dclarkasm/BartendingRobot/Design/pics/iso view.PNG

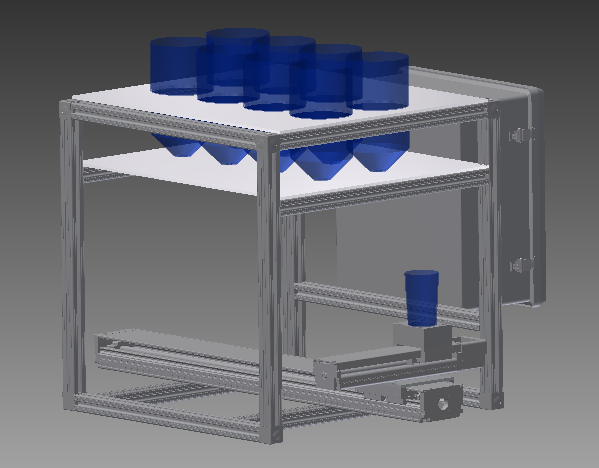
Design/pics/iso view.PNG
