dclarkasm/BartendingRobot/Design/pics/right side.PNG

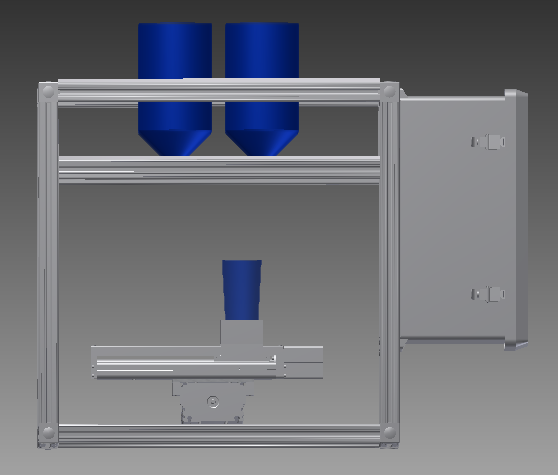
Design/pics/right side.PNG
