dclarkasm/BartendingRobot/programing/mpide/Adafruit-Flow-Meter-master/Adafruit-Flow-Meter-master/README.txt

This is example code for using the Adafruit liquid flow meters. 

Tested and works great with the Adafruit plastic and brass meters
    ------> http://www.adafruit.com/products/828
    ------> http://www.adafruit.com/products/833

Connect the red wire to +5V, the black wire to common ground and the yellow sensor wire to pin #2

Adafruit invests time and resources providing this open source code, 
please support Adafruit and open-source hardware by purchasing 
products from Adafruit!

Written by Limor Fried/Ladyada  for Adafruit Industries.  
BSD license, check license.txt for more information
All text above must be included in any redistribution
