dclarkasm/BartendingRobot/Schematics/flow chart.pptx

System power up

Connect phone to Android IOIO

Open Android application

Normal mode

Wait for drink selection

No drink selected

Manual mode

Set manual control bit to high

Wait for user input
