dclarkasm/BartendingRobot/Schematics/Schematic.pptx

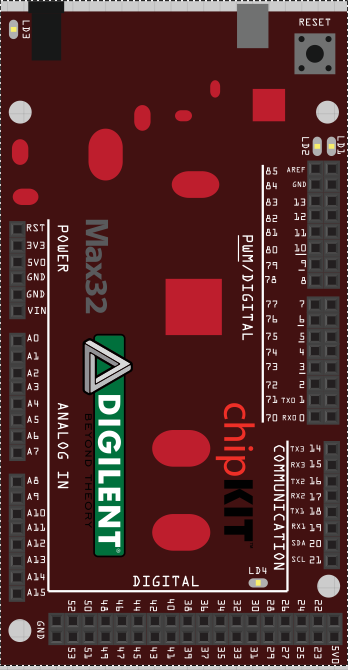
[picture p3: figure]
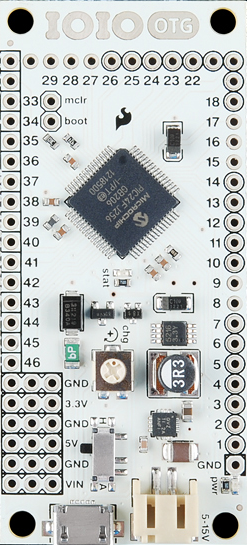
[picture p4: figure]

Key pos 3

Key pos 2

Z Pul

Z Dir

Key pos 1

Key pos 0

Y Pul

Y Dir

X Pul

X Dir

Home sensors

Flow
Meters

Solenoids

## Slide 2

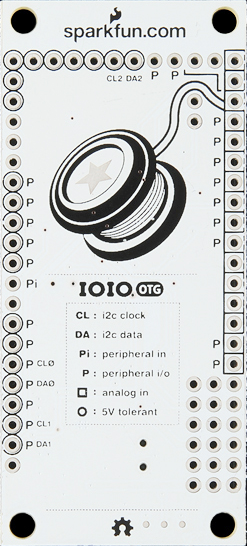
[picture p5: figure]
