dclarkasm/BartendingRobot/Schematics/robot pin out.xlsx

Sheet: Sheet1
descripion | uC | i/o device
screw diver order in | 42 | IOIO 18
cuba libre order in | 43 | IOIO 19 | legend
shiley temple order in | 44 | IOIO 20 | input
matini order in | 45 | IOIO 21 | ouput
manual home | 50 | IOIO 22
jog forward | 43 | IOIO 18
jog right | 44 | IOIO 19
jog reverse | 45 | IOIO 20
jog left | 42 | IOIO 21
manual control | 80 | IOIO 24
y home sensor | 39 | y home sensor
x home sensor | 38 | x home sensor
z home sensor | 41 | z home sensor
flow 1 | 30 | flow 1
flow 2 | 31 | flow 2
flow 3 | 49 | flow 3
flow 4 | 33 | flow 4
flow 5 | 34 | flow 5
flow 6 | 35 | flow 6
flow 7 | 24 | flow 7
flow 8 | 37 | flow 8
jog up | 22 | IOIO 31
jog down | 23 | IOIO 32
manual solenoid bit 1 | 28 | IOIO 33
manual solenoid bit 2 | 25 | IOIO 41
manual solenoid bit 3 | 26 | IOIO 42
manual solenoid bit 4 | 27 | IOIO 43
pulse x | 10 | pulse x
direction x | 11 | direction x
pulse y | 6 | pulse y
direction y | 7 | direction y
pulse z | 8 | pulse z
direction z | 9 | direction z
vodka out | 78 | vodka out
rum out | 71 | rum out
gin out | 72 | gin out
vermouth out | 73 | vermouth out
oj out | 74 | oj out
coke out | 75 | coke out
sprite out | 76 | sprite out
grenadine out | 77 | grenadine out
acknowledgment trans | 48 | IOIO 44

Sheet: Sheet1 (2)
 | description | Pins # | i/o device
 | description | Pins # | i/o device
1 | pulse y | 6 | pulse y
2 | direction y | 7 | direction y | legend
3 | pulse z | 8 | pulse z | input
4 | direction z | 9 | direction z | ouput
5 | pulse x | 10 | pulse x
6 | direction x | 11 | direction x
7 | jog up | 22 | IOIO 31
8 | jog down | 23 | IOIO 32
9 | flow 7 | 24 | flow 7
10 | manual solenoid bit 2 | 25 | IOIO 41
11 | manual solenoid bit 3 | 26 | IOIO 42
12 | manual solenoid bit 4 | 27 | IOIO 43
13 | manual solenoid bit 1 | 28 | IOIO 33
14 | flow 1 | 30 | flow 1
15 | flow 2 | 31 | flow 2
16 | flow 4 | 33 | flow 4
17 | flow 5 | 34 | flow 5
18 | flow 6 | 35 | flow 6
19 | flow 8 | 37 | flow 8
20 | x home sensor | 38 | x home sensor
21 | y home sensor | 39 | y home sensor
22 | z home sensor | 41 | z home sensor
23 | screw diver order in | 42 | IOIO 18
24 | jog left | 42 | IOIO 21
25 | cuba libre order in | 43 | IOIO 19
26 | jog forward | 43 | IOIO 18
27 | shiley temple order in | 44 | IOIO 20
28 | jog right | 44 | IOIO 19
29 | matini order in | 45 | IOIO 21
30 | jog reverse | 45 | IOIO 20
31 | acknowledgment trans | 48 | IOIO 44
32 | flow 3 | 49 | flow 3
33 | manual home | 50 | IOIO 22
34 | rum out | 71 | rum out
35 | gin out | 72 | gin out
36 | vermouth out | 73 | vermouth out
37 | oj out | 74 | oj out
38 | coke out | 75 | coke out
39 | sprite out | 76 | sprite out
40 | grenadine out | 77 | grenadine out
41 | vodka out | 78 | vodka out
42 | manual control | 80 | IOIO 24
