dclarkasm/BartendingRobot/Design/Panel asm2 drawing.pdf

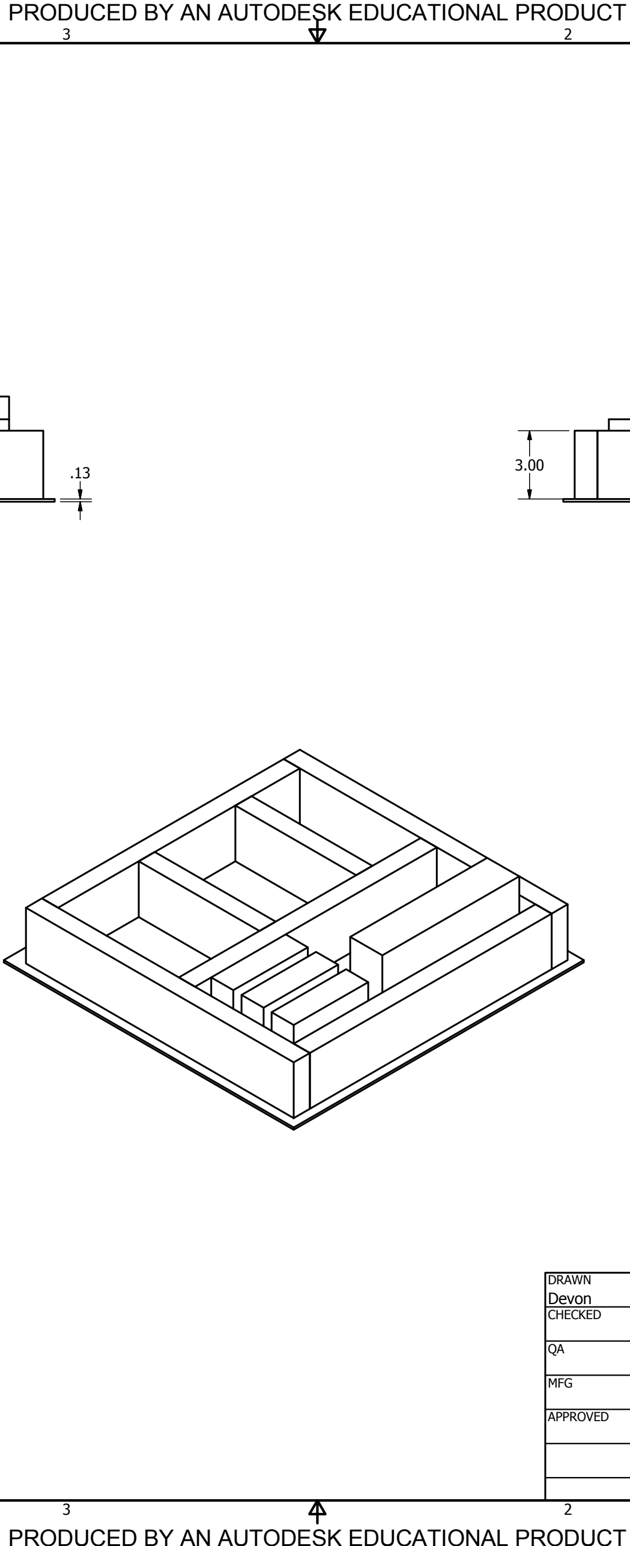
[picture p6: figure]
TIO N

PRODUCED BY AN AUTODESK EDUCATIONAL PRODUCT PRODUCED BY AN AUTODESK EDUCATIONAL PRODUCT

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
el a

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
