dclarkasm/BartendingRobot/Android App/pics/Account.PNG

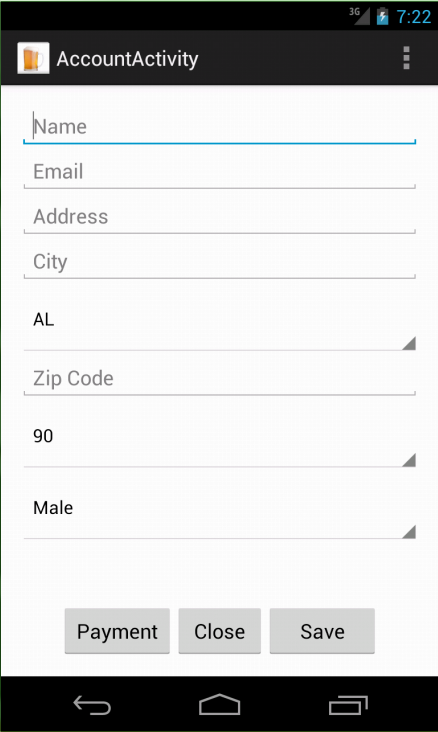
Android App/pics/Account.PNG
