dclarkasm/BartendingRobot/Android App/pics/App design.PNG

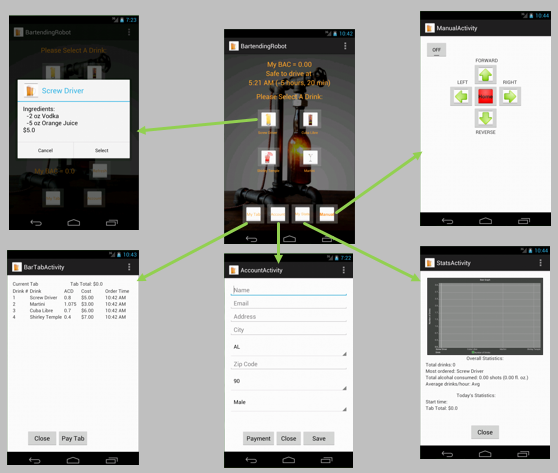
Android App/pics/App design.PNG
