dclarkasm/BartendingRobot/Android App/pics/bar tab.PNG

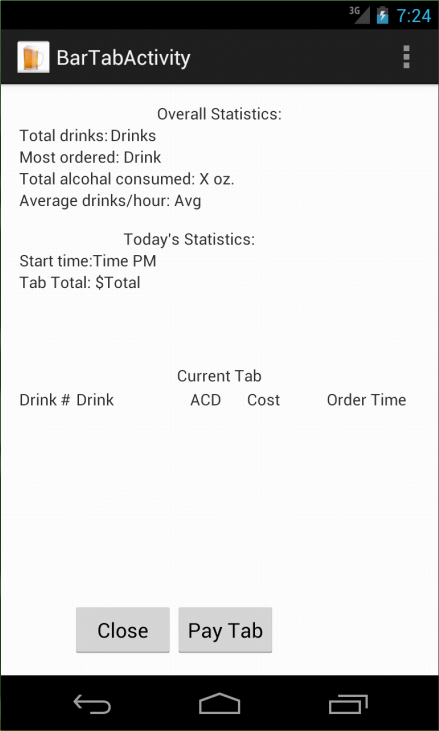
Android App/pics/bar tab.PNG
