dclarkasm/BartendingRobot/Android App/pics/downarrow.png

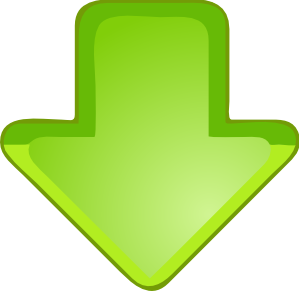
Android App/pics/downarrow.png
