dclarkasm/BartendingRobot/Android App/pics/drink select.PNG

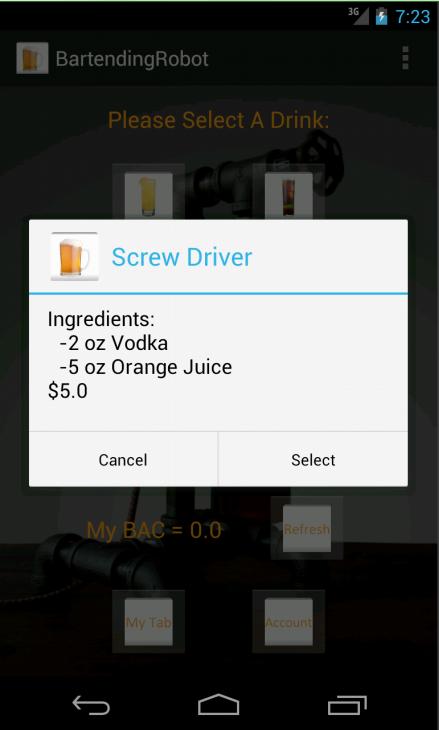
Android App/pics/drink select.PNG
