dclarkasm/BartendingRobot/Android App/pics/home screen.PNG

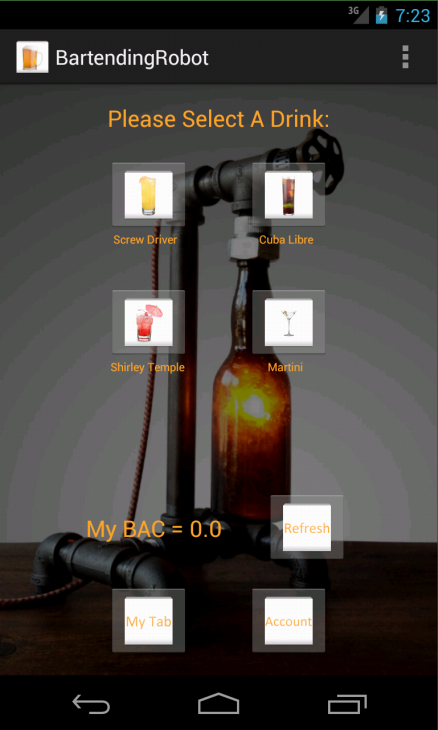
Android App/pics/home screen.PNG
