dclarkasm/BartendingRobot/Android App/pics/leftarrow.png

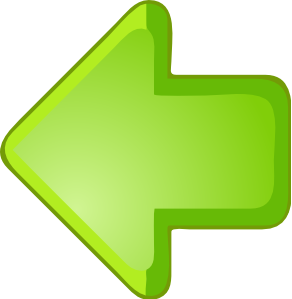
Android App/pics/leftarrow.png
