dclarkasm/BartendingRobot/Android App/pics/rightarrow.png

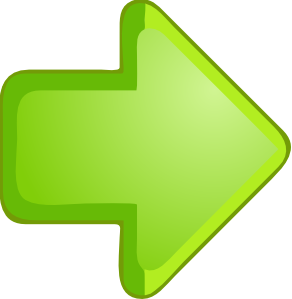
Android App/pics/rightarrow.png
