dclarkasm/BartendingRobot/Design/front.PNG

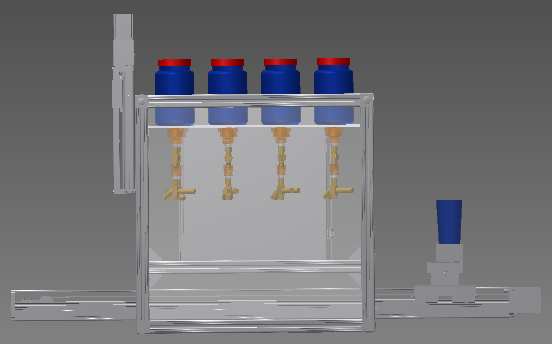
Design/front.PNG
