dclarkasm/BartendingRobot/Design/panel drawing.PNG

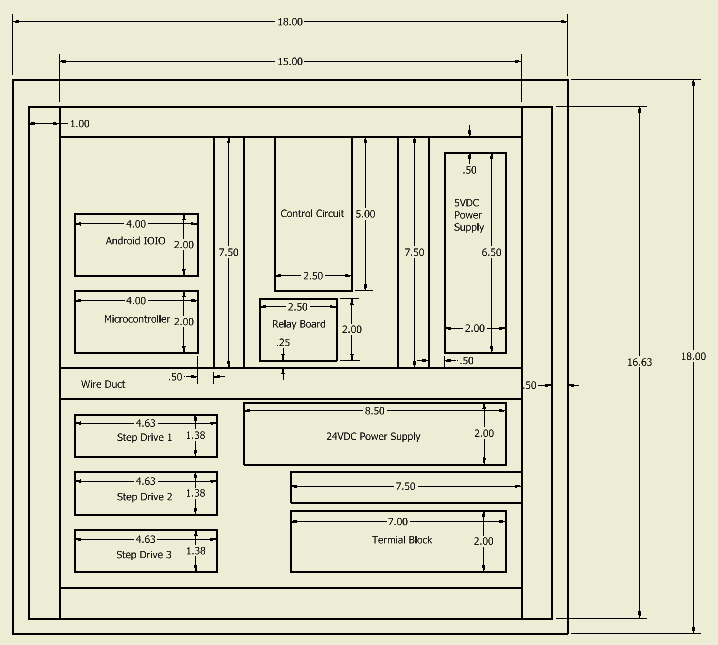
Design/panel drawing.PNG
