dclarkasm/BartendingRobot/Design/panel model.PNG

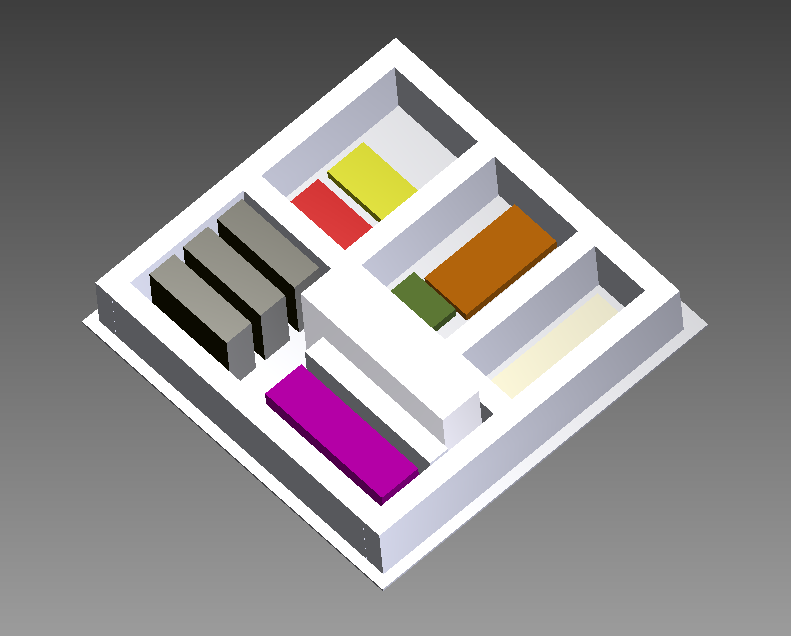
Design/panel model.PNG
