dclarkasm/BartendingRobot/Design/pics/front.PNG

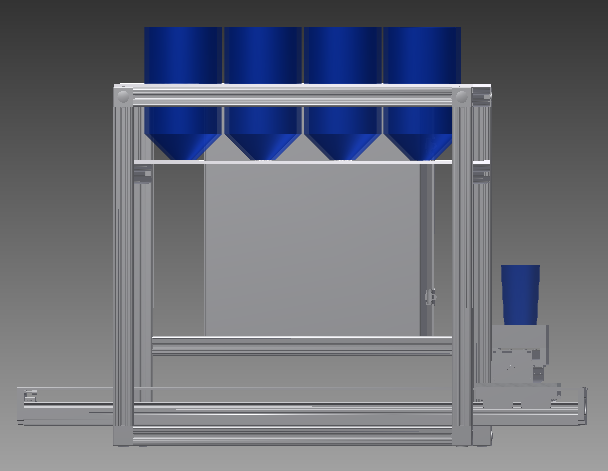
Design/pics/front.PNG
