dclarkasm/BartendingRobot/Design/side.PNG

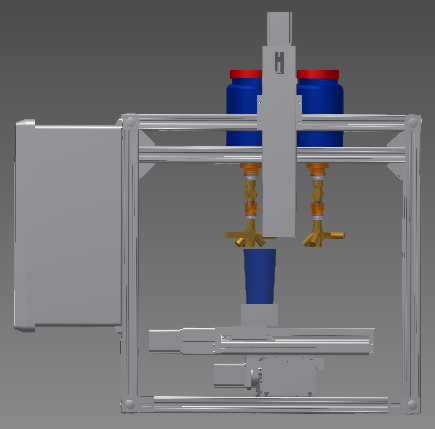
Design/side.PNG
