dclarkasm/BartendingRobot/Design/top.PNG

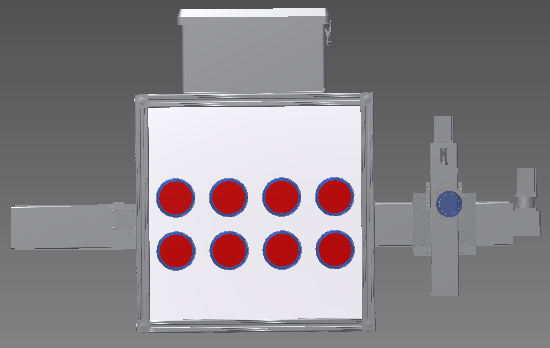
Design/top.PNG
