dclarkasm/BartendingRobot/Schematics/20140426_170252.jpg

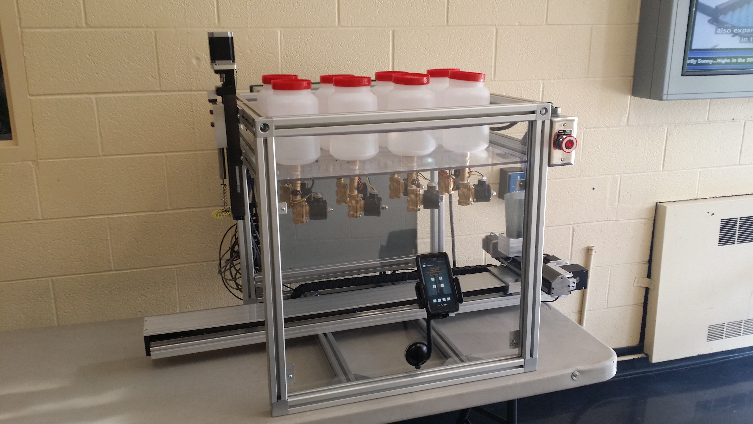
Schematics/20140426_170252.jpg
