dclarkasm/BartendingRobot/Schematics/20140426_170310.jpg

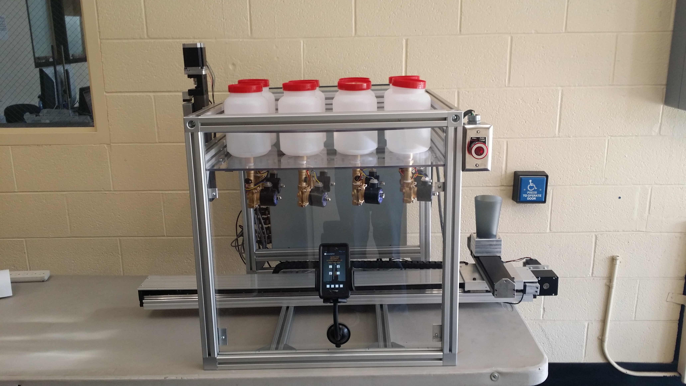
Schematics/20140426_170310.jpg
