dclarkasm/BartendingRobot/Schematics/20140426_170319.jpg

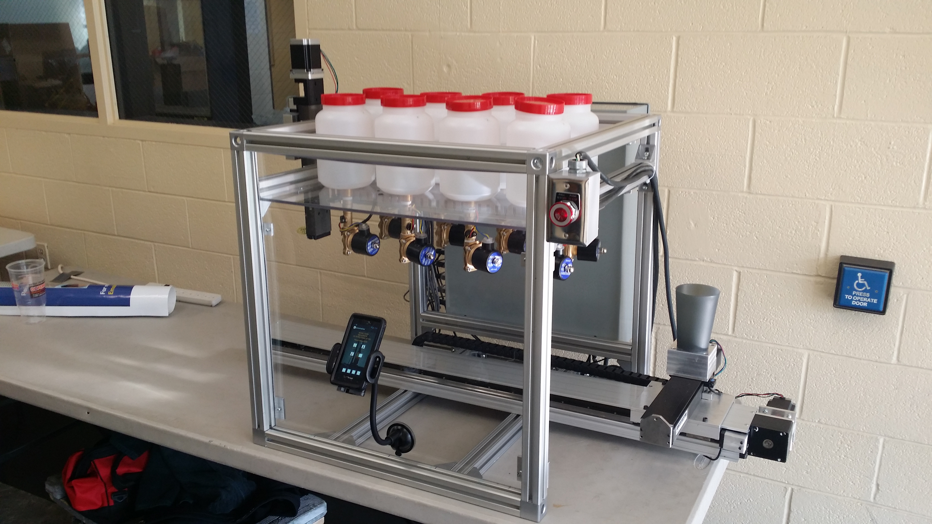
Schematics/20140426_170319.jpg
