dclarkasm/BartendingRobot/Schematics/app flow.PNG

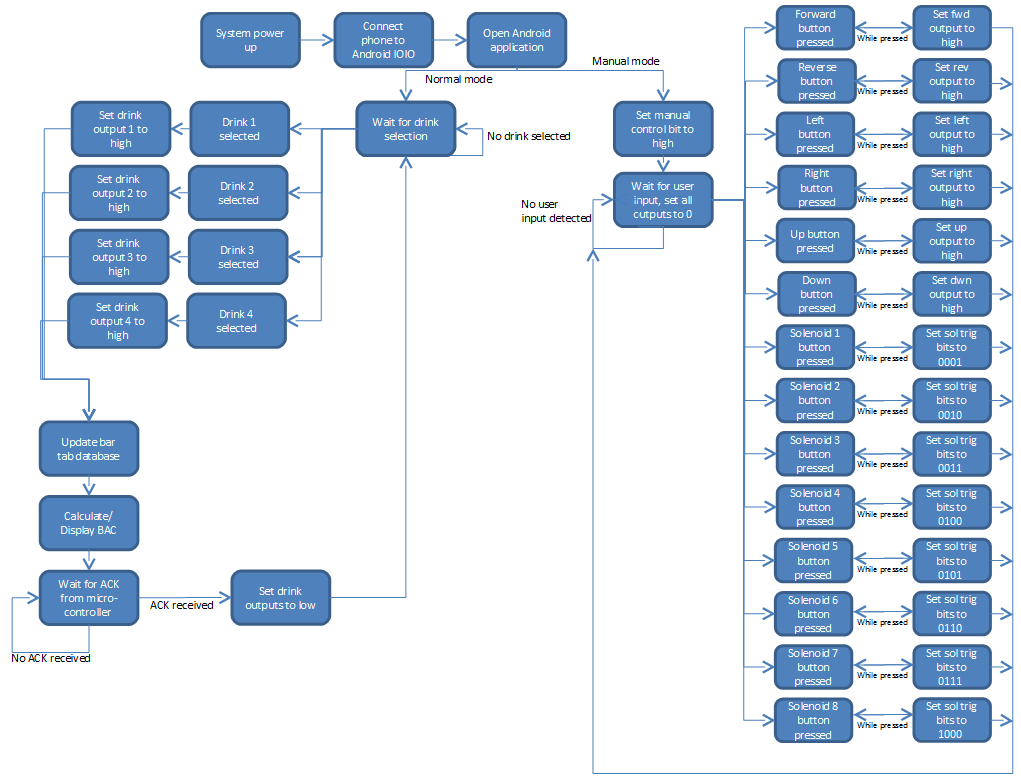
Schematics/app flow.PNG
