dclarkasm/BartendingRobot/Schematics/Block Diagram.bmp

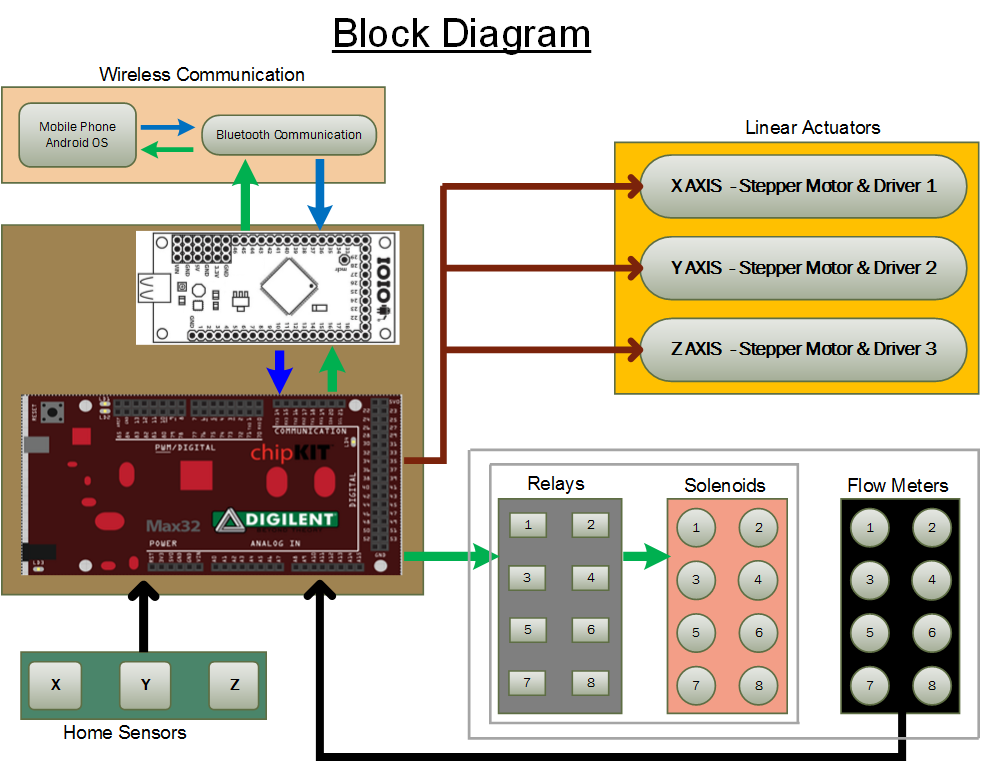
Schematics/Block Diagram.bmp
