dclarkasm/BartendingRobot/Schematics/drink flow.PNG

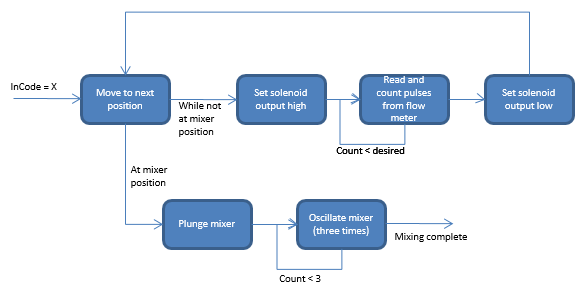
Schematics/drink flow.PNG
