dclarkasm/BartendingRobot/Schematics/micro c flow.PNG

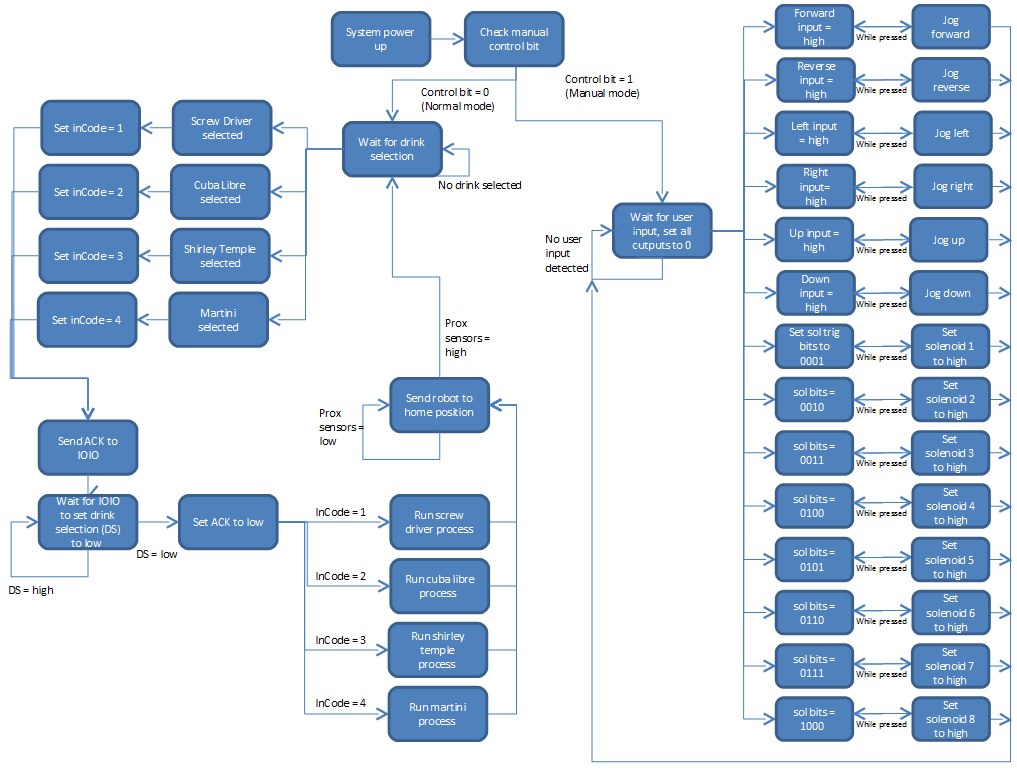
Schematics/micro c flow.PNG
