dclarkasm/BartendingRobot/Schematics/regulators.PNG

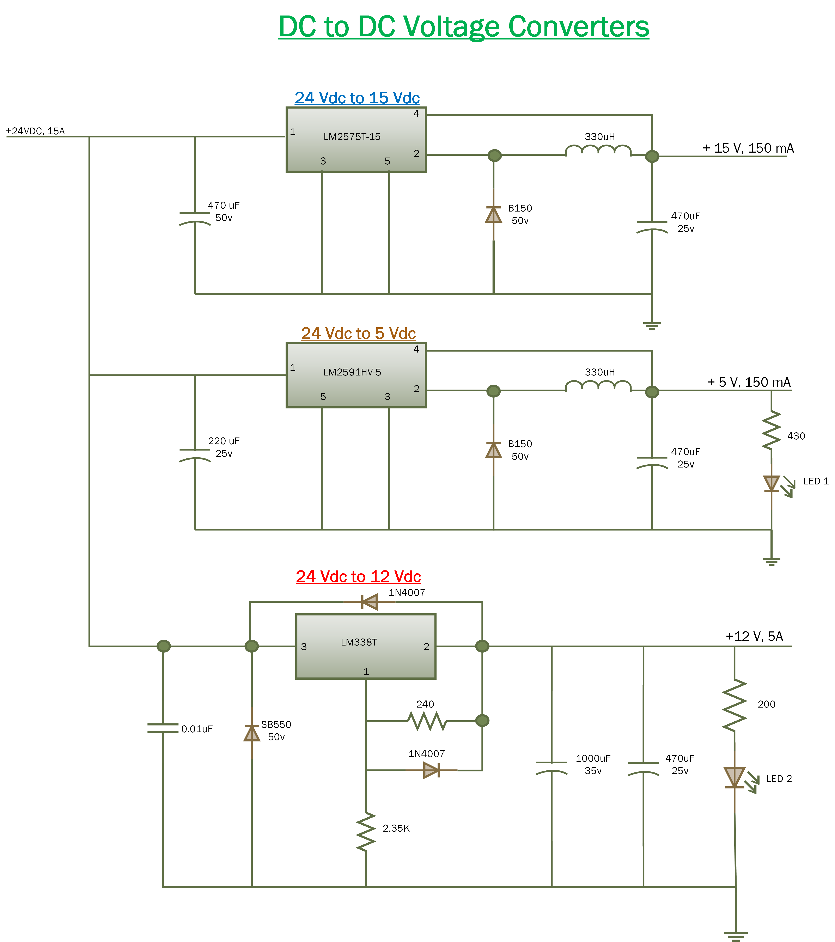
Schematics/regulators.PNG
