dclarkasm/BartendingRobot/Schematics/Solenoids.PNG

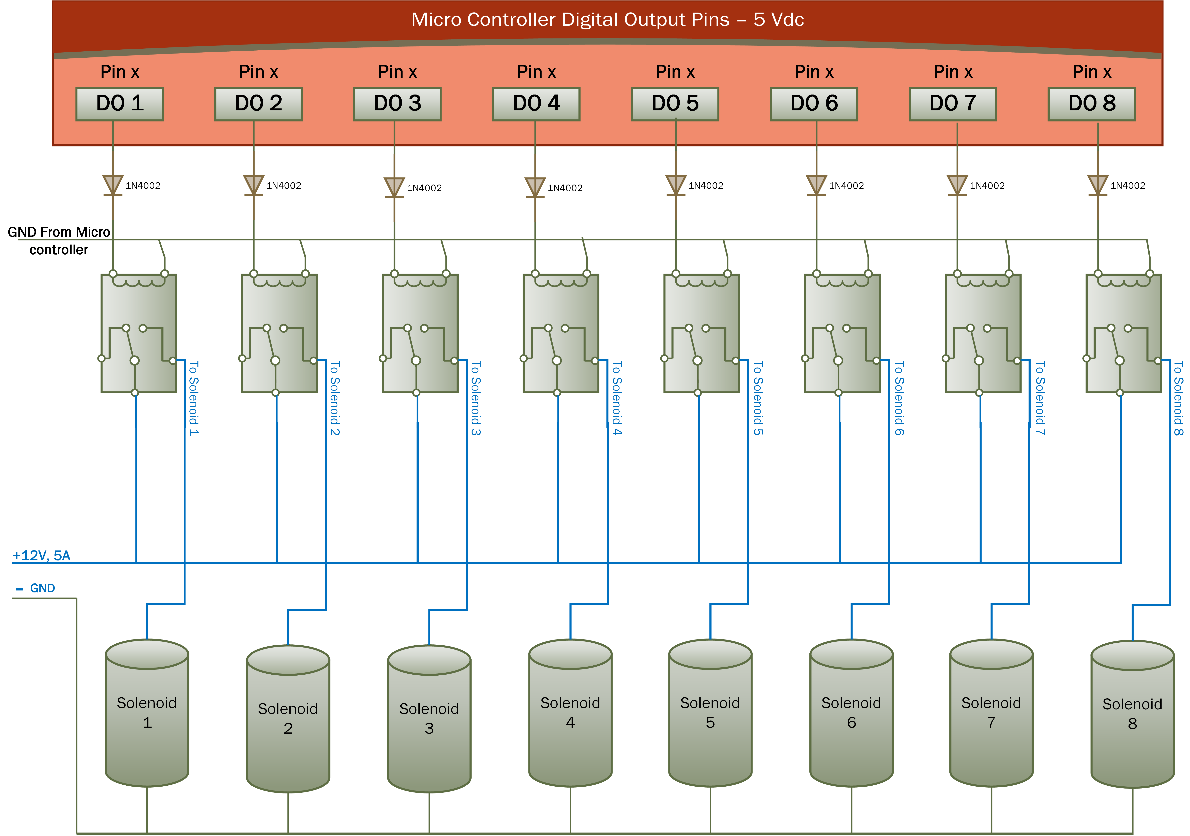
Schematics/Solenoids.PNG
