dclarkasm/BartendingRobot/Schematics/unnamed.jpg

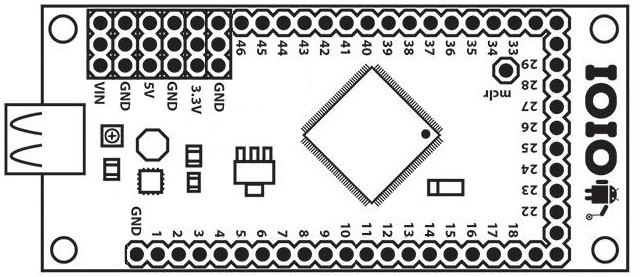
Schematics/unnamed.jpg
