dclarkasm/BartendingRobot/Design/flow/.5-.375in coupling.IGS

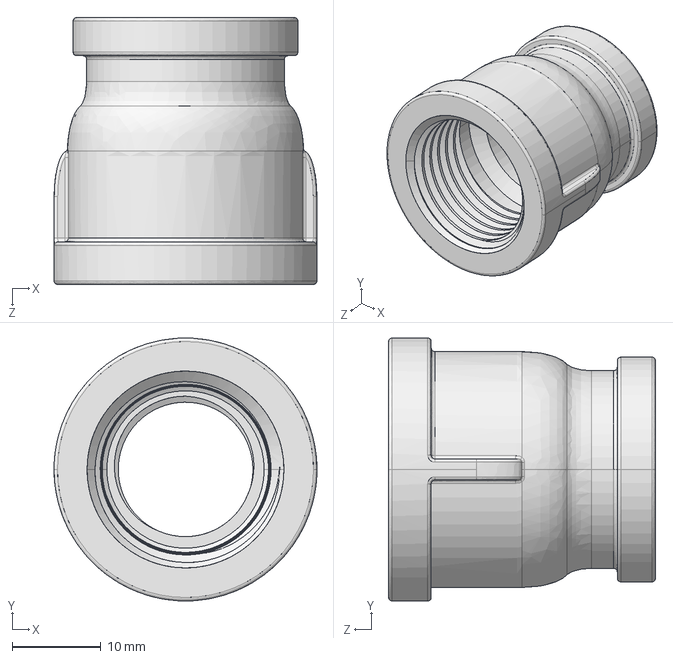
[picture p31: CAD file, 2016-03-17]
Design/flow/.5-.375in coupling.IGS
29.7 x 29.7 x 30.2 mm
