dclarkasm/BartendingRobot/Design/flow/.375 nipple.IGS

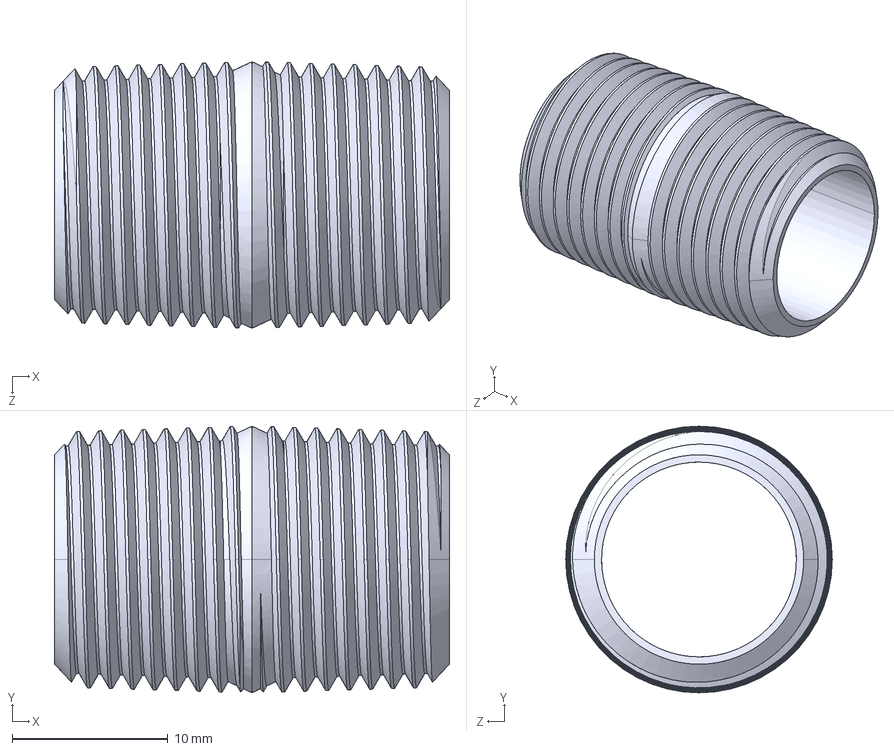
[picture p32: CAD file, 2016-03-17]
Design/flow/.375 nipple.IGS
25.4 x 17.1 x 17.1 mm
