dclarkasm/BartendingRobot/Design/flow/.5 in bulkhead fitting.IGS

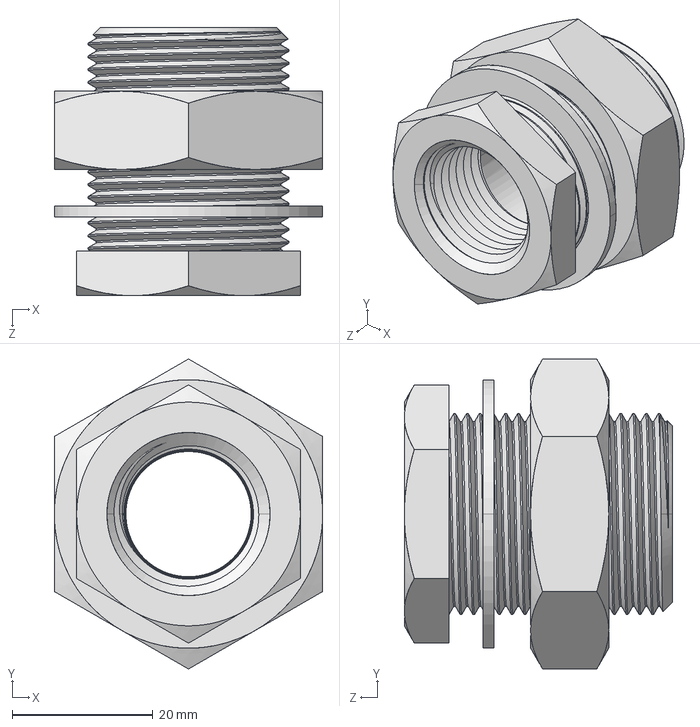
[picture p33: CAD file, 2016-03-17]
Design/flow/.5 in bulkhead fitting.IGS
38.1 x 44.0 x 38.1 mm
