dclarkasm/BartendingRobot/Design/flow/.5in nipple.IGS

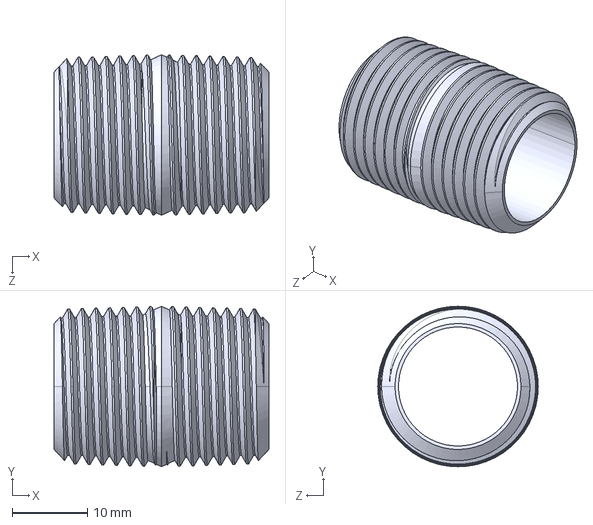
[picture p34: CAD file, 2016-03-17]
Design/flow/.5in nipple.IGS
28.6 x 21.3 x 21.3 mm
