dclarkasm/BartendingRobot/Design/Electrical/7641K711.STEP

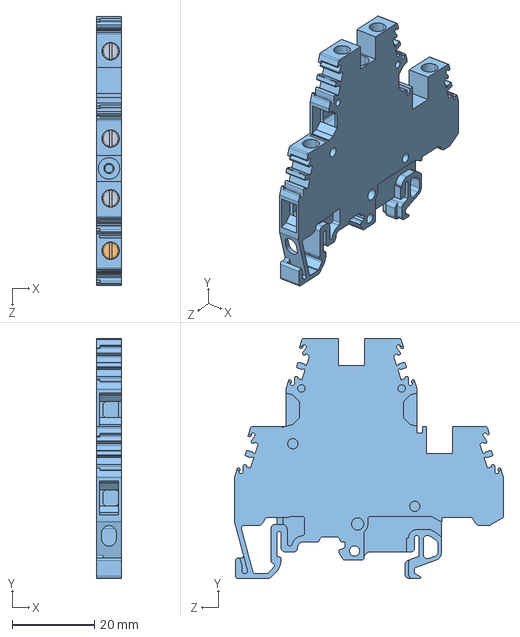
[picture p35: CAD file, 2016-03-17]
Design/Electrical/7641K711.STEP
6.00 x 58.5 x 65.6 mm
