dclarkasm/BartendingRobot/Design/extrusion fittings/5537T510.STEP

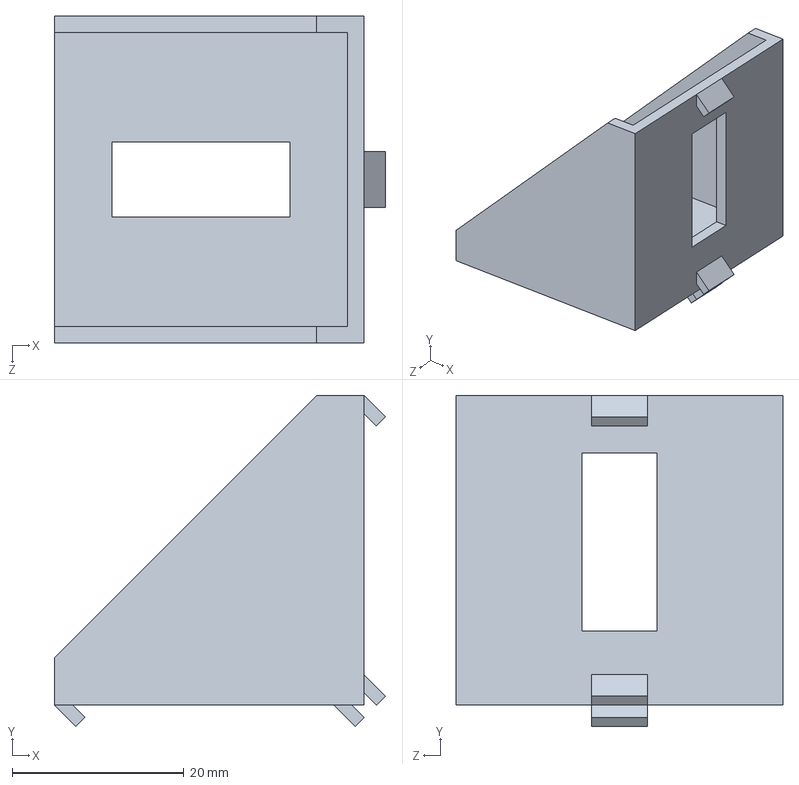
[picture p36: CAD file, 2016-03-17]
Design/extrusion fittings/5537T510.STEP
38.5 x 38.5 x 38.0 mm
