dclarkasm/BartendingRobot/Design/flow/36895K161.IGS

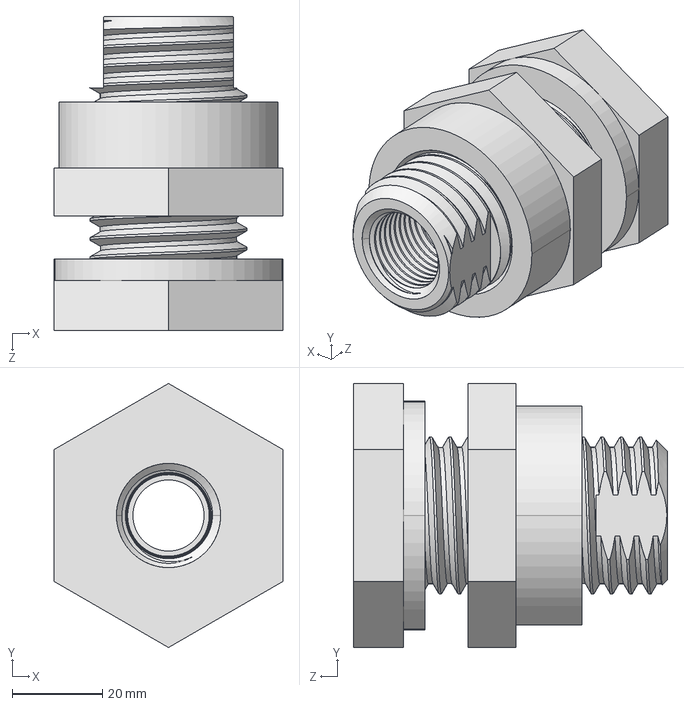
[picture p37: CAD file, 2016-03-17]
Design/flow/36895K161.IGS
50.8 x 58.7 x 69.8 mm
