dclarkasm/BartendingRobot/(list of files, cad)

Other CAD files:
Design/servo motor/QCI-A23L-1_SW/23 Extrusion with connector and seal.sldasm
Design/servo motor/QCI-A23L-1_SW/QCI-A23L-1.sldasm
Design/servo motor/QCI-A23L-1_SW/Web page info.sldprt
Design/servo motor/QCI-A23L-1_SW/extrusion.sldprt
Design/servo motor/QCI-A23L-1_SW/QCI.sldprt
Design/servo motor/QCI-A23L-1_SW/15 pin HD M.sldprt
Design/servo motor/QCI-A23L-1_SW/23 Label.sldprt
Design/servo motor/QCI-A23L-1_SW/23L-1.sldprt
Design/servo motor/QCI-A23L-1_SW/4-40 jack screw.sldprt
Design/1.5 in. aluminum extrusion/14.156in.ipt
Design/1.5 in. aluminum extrusion/5.094in.ipt
Design/1.5 in. aluminum extrusion/7in.ipt
Design/1.5 in. aluminum extrusion/Imported Components/47065T210/OldVersions/Part32.0001.ipt
Design/1.5 in. aluminum extrusion/Imported Components/47065T210/OldVersions/Part34.0001.ipt
Design/1.5 in. aluminum extrusion/Imported Components/47065T210/Part10.ipt
Design/1.5 in. aluminum extrusion/Imported Components/47065T210/Part2.ipt
Design/1.5 in. aluminum extrusion/Imported Components/47065T210/Part3.ipt
Design/1.5 in. aluminum extrusion/Imported Components/47065T210/Part32.ipt
Design/1.5 in. aluminum extrusion/Imported Components/47065T210/Part34.ipt
Design/1.5 in. aluminum extrusion/Imported Components/47065T210/Part4.ipt
Design/1.5 in. aluminum extrusion/Imported Components/47065T210/Part5.ipt
Design/1.5 in. aluminum extrusion/OldVersions/7in.0001.ipt
Design/340mm KR linear actuator/PARTserver64609951/KR45H 10A + 340L0 - 00A0(0-0).iam
Design/340mm KR linear actuator/PARTserver64609951/KR45H(A-1)-Slider.ipt
Design/340mm KR linear actuator/PARTserver64609951/KR45HA-340L-0A0-Body.ipt
Design/340mm KR linear actuator/PARTserver64610126with cover/KR45H 10A + 340L0 - 10A0(0-0).iam
Design/340mm KR linear actuator/PARTserver64610126with cover/KR45H(A-1)-Slider.ipt
Design/340mm KR linear actuator/PARTserver64610126with cover/KR45H-340-Protected Cover.ipt
Design/340mm KR linear actuator/PARTserver64610126with cover/KR45H-A-Slider Spacer.ipt
Design/340mm KR linear actuator/PARTserver64610126with cover/KR45HA-340L-1A0-Body.ipt
Design/980mm KR linear actuator/KR55 20A + 980L0 - 10A0(826-0).iam
Design/980mm KR linear actuator/KR55(A-1)-Slider.ipt
Design/980mm KR linear actuator/KR55-980-Protected Cover.ipt
Design/980mm KR linear actuator/KR55-A-Slider Spacer.ipt
Design/980mm KR linear actuator/KR55A-980L-1A0-Body.ipt
Design/980mm KR linear actuator/NEMA23 frame size/GL20N-142-SW-EH--C-N-N-Y_(804U1).iam
Design/980mm KR linear actuator/NEMA23 frame size/GL20N41420CSW' Body2.ipt
Design/980mm KR linear actuator/NEMA23 frame size/GL20NL-typeExNY Table.ipt
Design/980mm KR linear actuator/NEMA23 frame size/GL20NU1 Y Motor bracket.ipt
Design/Bartender Robot Asm-1 drawing.idw
Design/Bartender Robot Asm.iam
Design/Electrical/15in wire duct.ipt
Design/Electrical/17in wire duct.ipt
Design/Electrical/2x6.5 PCB.ipt
Design/Electrical/4x6.5 PCB.ipt
Design/Electrical/5.625in wire duct.ipt
Design/Electrical/7.5in wire duct.ipt
Design/Electrical/AND Gate.ipt
Design/Electrical/IOIO.ipt
Design/Electrical/Imported Components/7641K711/7641K711.ipt
Design/Electrical/OldVersions/17in wire duct.0001.ipt
Design/Electrical/OldVersions/4x6.5 PCB.0001.ipt
Design/Electrical/OldVersions/Panel asm.0002.iam
Design/Electrical/OldVersions/Panel asm.0004.iam
Design/Electrical/OldVersions/Power Suplply.0001.ipt
Design/Electrical/OldVersions/Power Suplply.0002.ipt
Design/Electrical/OldVersions/Stepper Drive.0001.ipt
Design/Electrical/Panel asm.iam
Design/Electrical/Power Suplply.ipt
Design/Electrical/Stepper Drive.ipt
Design/Electrical/chipkit.ipt
Design/Electrical/panel.ipt
Design/Electrical/relay board.ipt
Design/Electrical/terminal block.ipt
Design/Enclosure/Imported Components/Enclosure/Assembly3.iam
Design/Enclosure/Imported Components/Enclosure/OldVersions/Assembly3.0001.iam
Design/Enclosure/Imported Components/Enclosure/OldVersions/Part18.0001.ipt
Design/Enclosure/Imported Components/Enclosure/OldVersions/Part20.0001.ipt
Design/Enclosure/Imported Components/Enclosure/OldVersions/Part22.0001.ipt
Design/Enclosure/Imported Components/Enclosure/OldVersions/Part24.0001.ipt
Design/Enclosure/Imported Components/Enclosure/OldVersions/Part26.0001.ipt
Design/Enclosure/Imported Components/Enclosure/OldVersions/Part28.0001.ipt
Design/Enclosure/Imported Components/Enclosure/OldVersions/Part30.0001.ipt
Design/Enclosure/Imported Components/Enclosure/Part18.ipt
Design/Enclosure/Imported Components/Enclosure/Part20.ipt
Design/Enclosure/Imported Components/Enclosure/Part22.ipt
Design/Enclosure/Imported Components/Enclosure/Part24.ipt
Design/Enclosure/Imported Components/Enclosure/Part26.ipt
Design/Enclosure/Imported Components/Enclosure/Part28.ipt
Design/Enclosure/Imported Components/Enclosure/Part30.ipt
Design/GL-N linear actuator/PARTserver64595412/GL15N-124-SW-EH--N-N-N-Y_(02N).iam
Design/GL-N linear actuator/PARTserver64595412/GL15N21240NSW' Body2.ipt
Design/GL-N linear actuator/PARTserver64595412/GL15NL-typeExSWNY Table.ipt
Design/GL-N linear actuator/PARTserver64610223withcover/GL15N-106-SW-B05-A-C-N-N-Y_(01A).iam
Design/GL-N linear actuator/PARTserver64610223withcover/GL15N11060CASW' Body2.ipt
Design/GL-N linear actuator/PARTserver64610223withcover/GL15NL-typeBxSWNY Table.ipt
Design/Imported Components/5537T510/OldVersions/Part6.0001.ipt
Design/Imported Components/5537T510/Part10.ipt
Design/Imported Components/5537T510/Part12.ipt
Design/Imported Components/5537T510/Part4.ipt
Design/Imported Components/5537T510/Part6.ipt
Design/Imported Components/5537T510/Part8.ipt
Design/Liquid Vessel/OldVersions/Vessel.0005.ipt
Design/Liquid Vessel/Vessel.ipt
Design/Liquid Vessel/cap.ipt
Design/OldVersions/Bartender Robot Asm-1 drawing.0001.idw
Design/OldVersions/Bartender Robot Asm-1 drawing.0002.idw
Design/OldVersions/Bartender Robot Asm-1 drawing.0003.idw
Design/OldVersions/Bartender Robot Asm.0011.iam
Design/OldVersions/Bartender Robot Asm.0012.iam
Design/OldVersions/Panel asm1 drawing.0001.idw
Design/OldVersions/Panel asm1 drawing.0003.idw
Design/Panel asm1 drawing.idw
Design/Panel asm2 drawing.idw
Design/VLA linear actuator/VLA-60-06-0700-N-000-N-N-N (0) (700).iam
Design/VLA linear actuator/VLA-ST-60-12-0050WSlider.ipt
Design/VLA linear actuator/VLA-ST-60-12-0700W Body.ipt
Design/extrusion fittings/Imported Components/1.5in 2 sided fastener/Assembly1.iam
Design/extrusion fittings/Imported Components/1.5in 2 sided fastener/Assembly2.iam
Design/extrusion fittings/Imported Components/1.5in 2 sided fastener/OldVersions/Assembly2.0001.iam
Design/extrusion fittings/Imported Components/1.5in 2 sided fastener/Part12.ipt
Design/extrusion fittings/Imported Components/1.5in 2 sided fastener/Part14.ipt
Design/extrusion fittings/Imported Components/1.5in 2 sided fastener/Part16.ipt
Design/extrusion fittings/Imported Components/1.5in 2 sided fastener/Part24.ipt
Design/extrusion fittings/Imported Components/1.5in 2 sided fastener/Part26.ipt
Design/extrusion fittings/Imported Components/1.5in 2 sided fastener/Part28.ipt
Design/extrusion fittings/Imported Components/1.5in 2 sided fastener/Part4.ipt
Design/extrusion fittings/Imported Components/1.5in 2 sided fastener/Part6.ipt
Design/extrusion fittings/Imported Components/1.5in 2 sided fastener/Part8.ipt
Design/extrusion fittings/Imported Components/1.5in 3 sided fastener/Assembly1.iam
Design/extrusion fittings/Imported Components/1.5in 3 sided fastener/Assembly2.iam
Design/extrusion fittings/Imported Components/1.5in 3 sided fastener/Assembly5.iam
Design/extrusion fittings/Imported Components/1.5in 3 sided fastener/Part10.ipt
Design/extrusion fittings/Imported Components/1.5in 3 sided fastener/Part12.ipt
Design/extrusion fittings/Imported Components/1.5in 3 sided fastener/Part14.ipt
Design/extrusion fittings/Imported Components/1.5in 3 sided fastener/Part16.ipt
Design/extrusion fittings/Imported Components/1.5in 3 sided fastener/Part2.ipt
Design/extrusion fittings/Imported Components/1.5in 3 sided fastener/Part36.ipt
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
