dclarkasm/BartendingRobot/Design/Final Mechanical Assembly.PNG

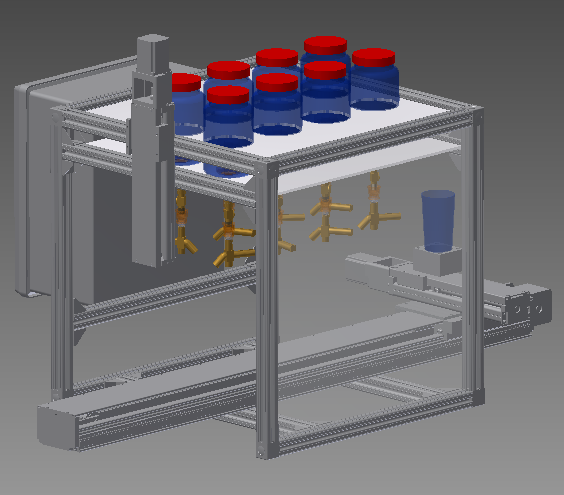
Design/Final Mechanical Assembly.PNG
