dclarkasm/BartendingRobot/Design/Bartender Robot Asm-1 drawing.pdf

## PRODUCED BY AN AUTODESK EDUCATIONAL PRODUCT

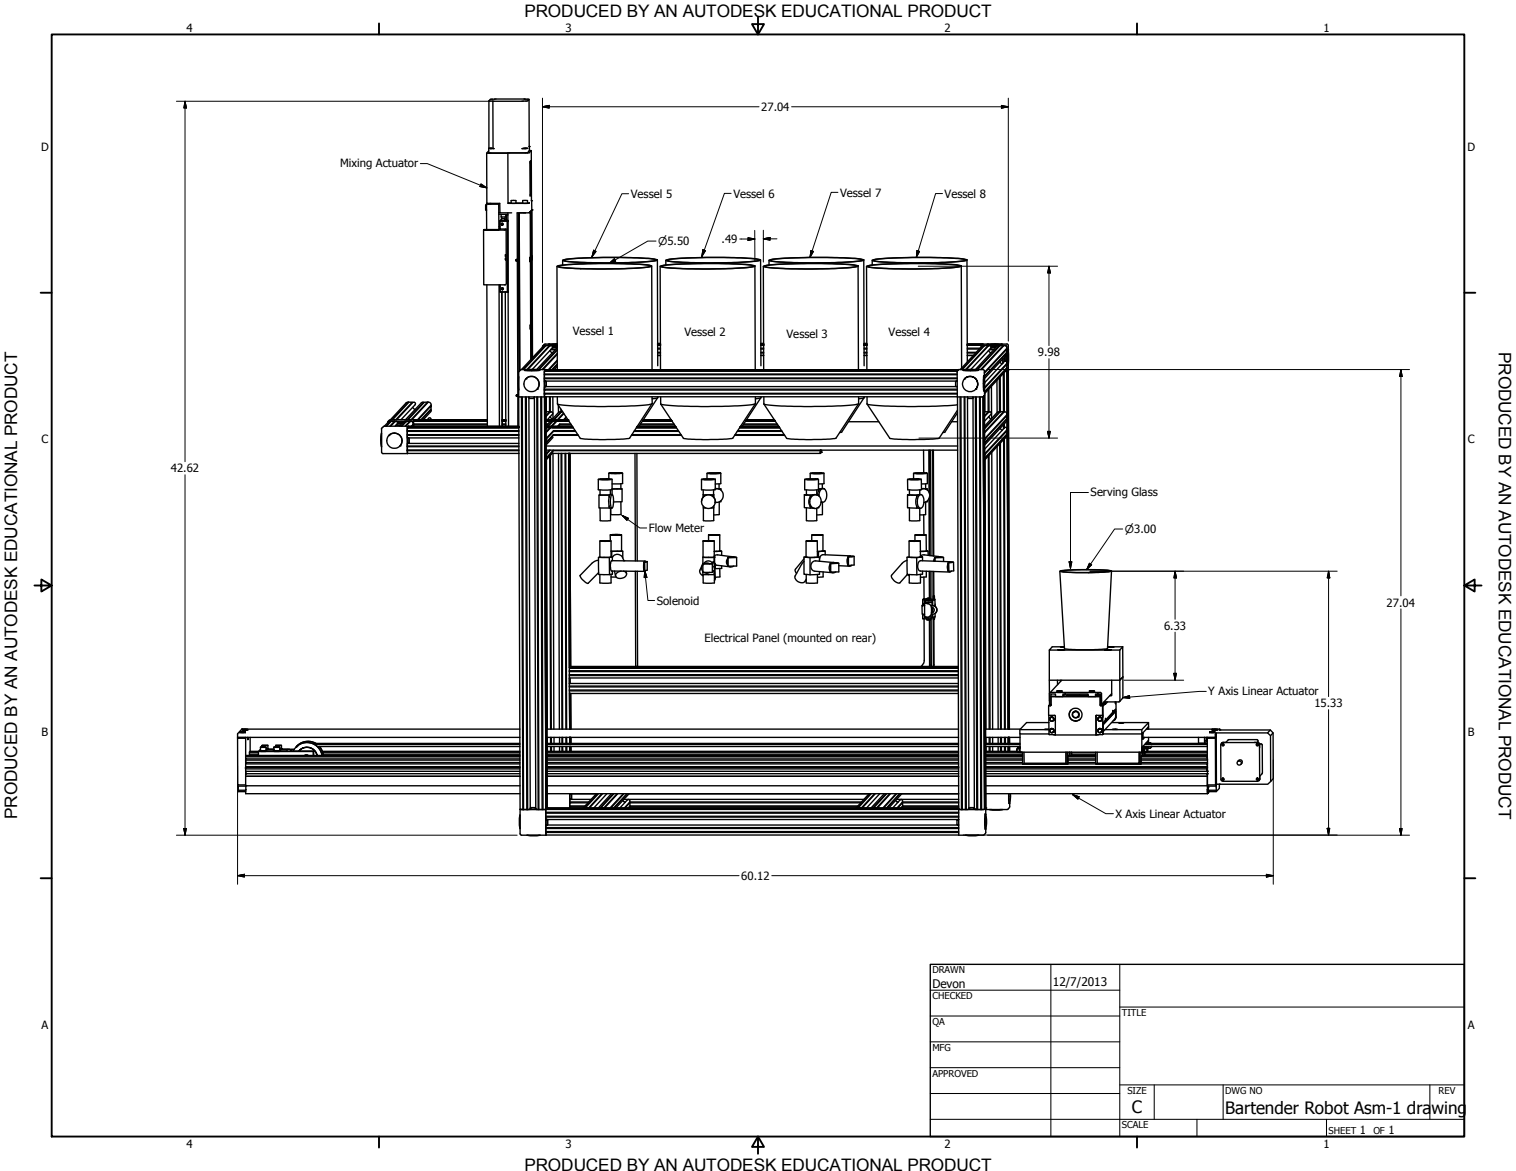
[picture p39: page 1]
TIO; P R O D U C E D B Y A N A U T O D E S K E D U C A TIO; SHEET 1 OF 1; DRAWN; CHECKED; MFG; APPROVED; Devon; TITLE; SIZE C; SCALE; REV; Vessel 1; Vessel 2; Vessel 3; Vessel 4; Solenoid; Flow Meter; Mixing Actuator; Serving Glass; Vessel 5; Vessel 6; Vessel 7; Vessel 8

Electrical Panel (mounted on rear)

Y Axis Linear Actuator

X Axis Linear Actuator

DWG NO
Bartender Robot Asm-1 drawing

PRODUCED BY AN AUTODESK EDUCATIONAL PRODUCT
