dclarkasm/BartendingRobot/Schematics/SchematicsAllinOne.pdf

# Block Diagram

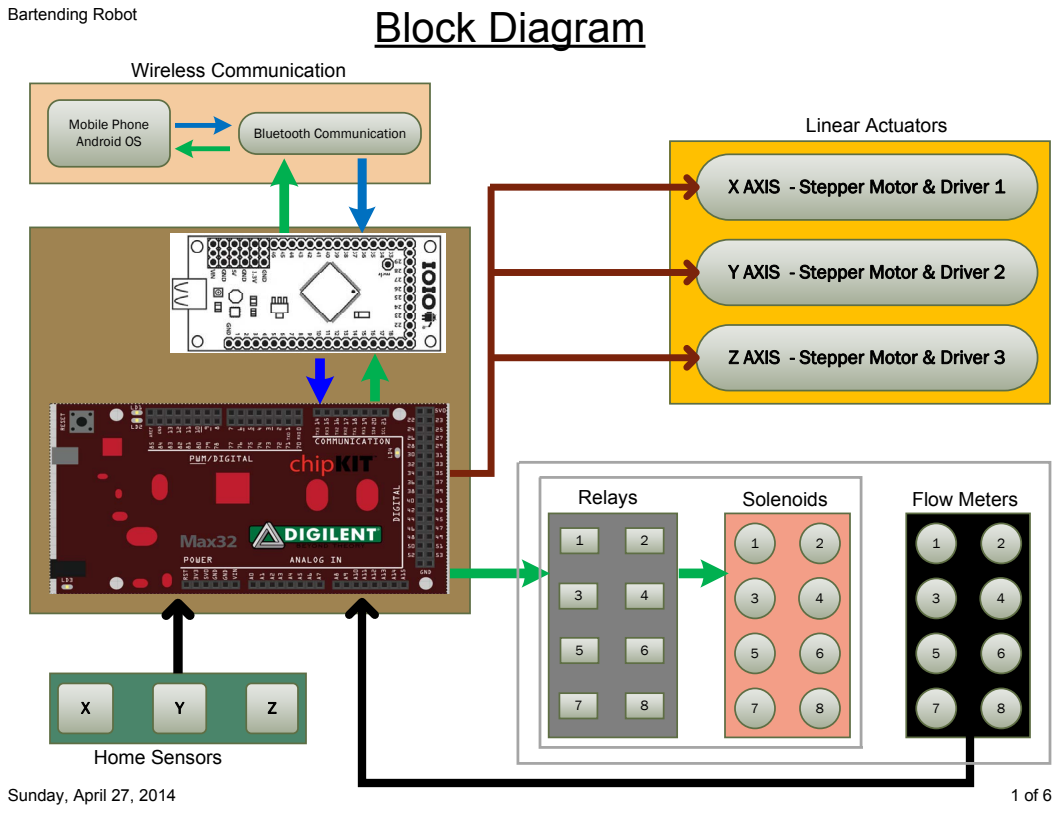
[picture p40: page 1]
Wireless Communication; Mobile Phone; Android OS; Bluetooth Communication; Linear Actuators; Bartending Robot; Sunday, April 27, 2014; Relays; Solenoids; Flow Meters; Home Sensors

X AXIS - Stepper Motor & Driver 1

Y AXIS - Stepper Motor & Driver 2

Z AXIS - Stepper Motor & Driver 3

## Microcontroller and IOIO

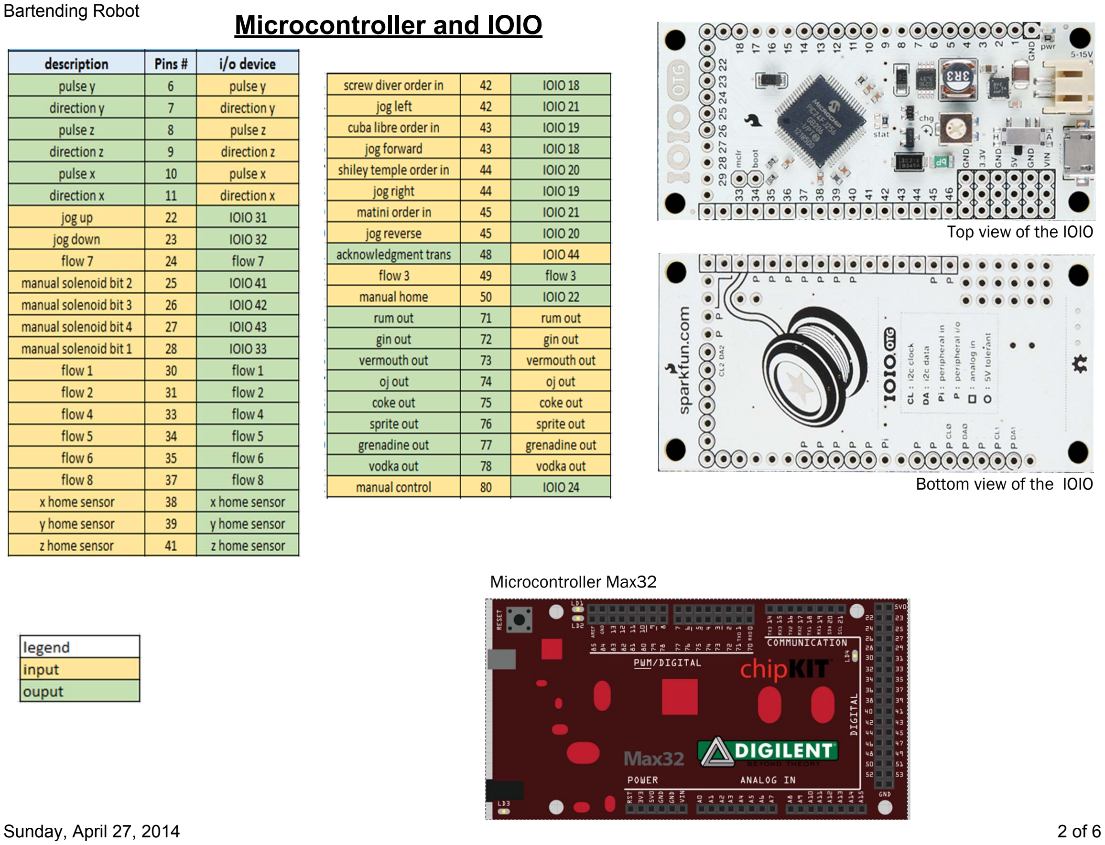
[picture p41: page 2]

Bottom view of the IOIO

Top view of the IOIO

Microcontroller Max32

## Solenoids Circuit

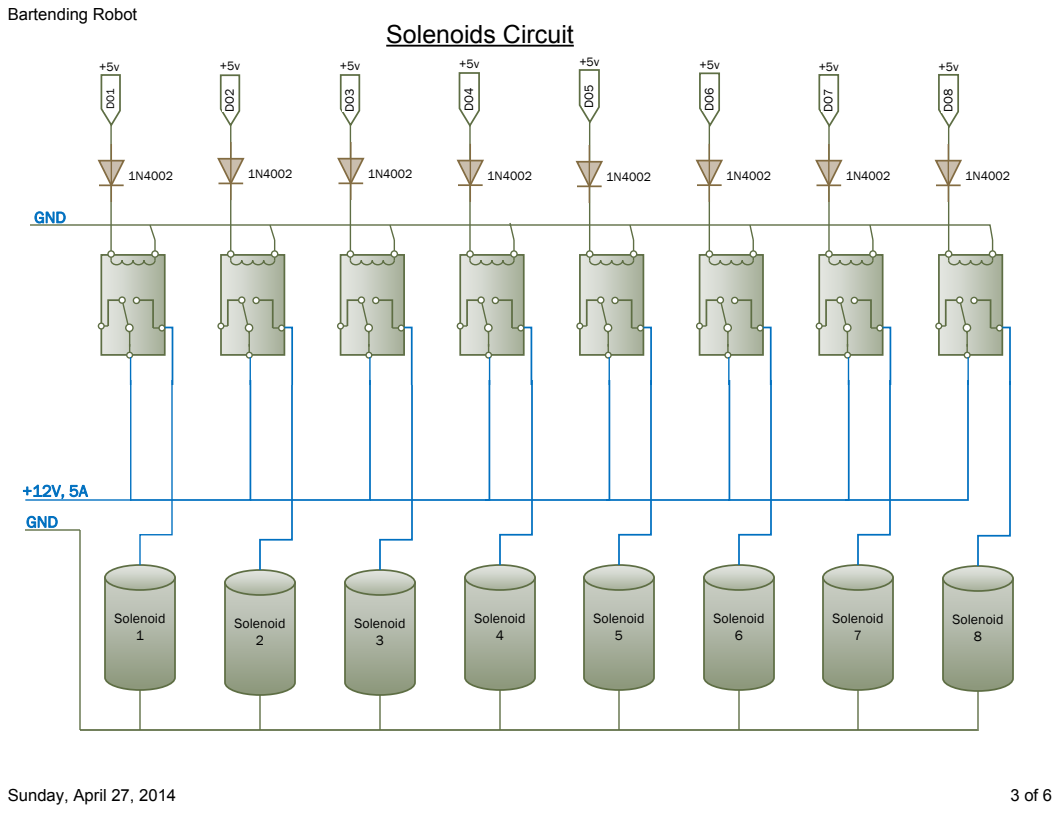
[picture p42: page 3]
Solenoid 1; Solenoid 2; Solenoid 3; Solenoid 4; Solenoid 5; Solenoid 6; Solenoid 7; Solenoid 8; GND

## DC to DC Voltage Converters

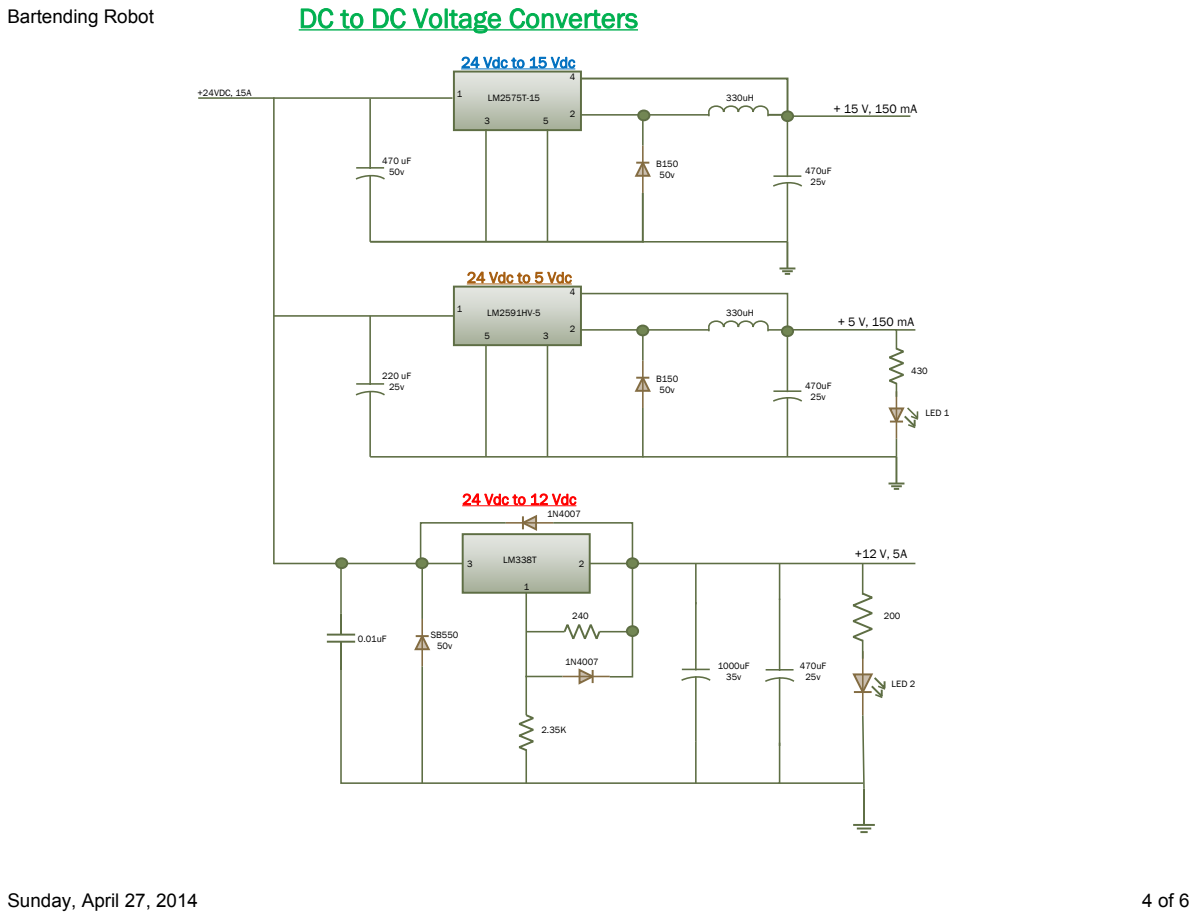
[picture p43: page 4]
+24VDC, 15A; LED 2; LED 1

24 Vdc to 15 Vdc

24 Vdc to 5 Vdc

24 Vdc to 12 Vdc

## AND Gate Circuit

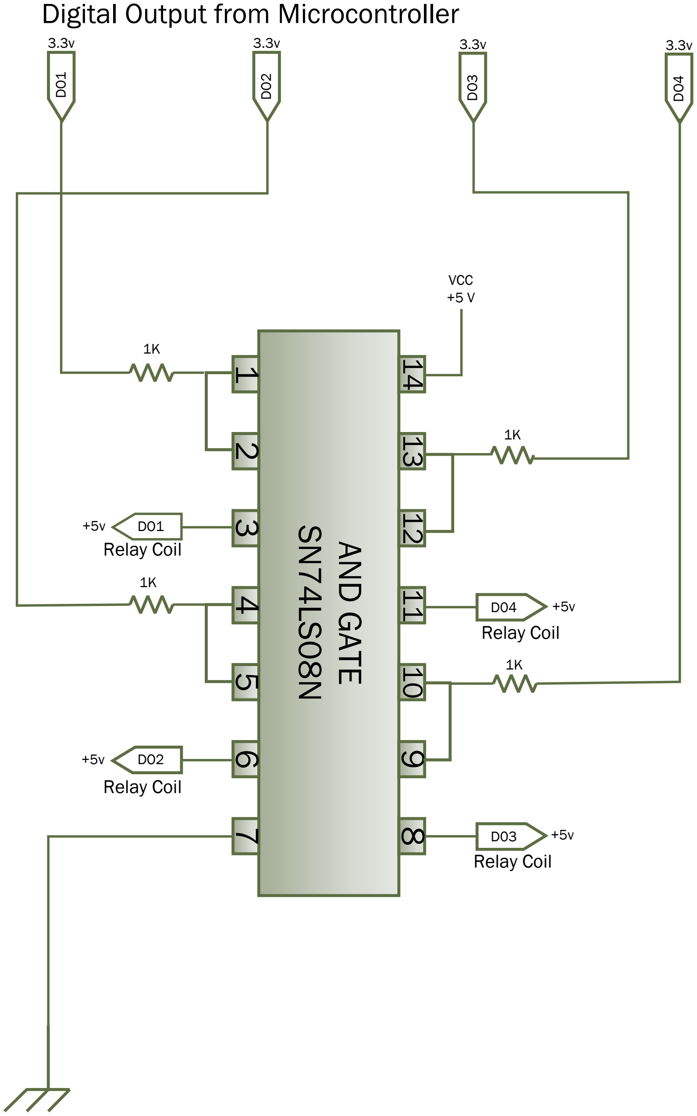
[picture p44: figure]
AND GATE; VCC +5 V; Digital Output from Microcontroller; Relay Coil
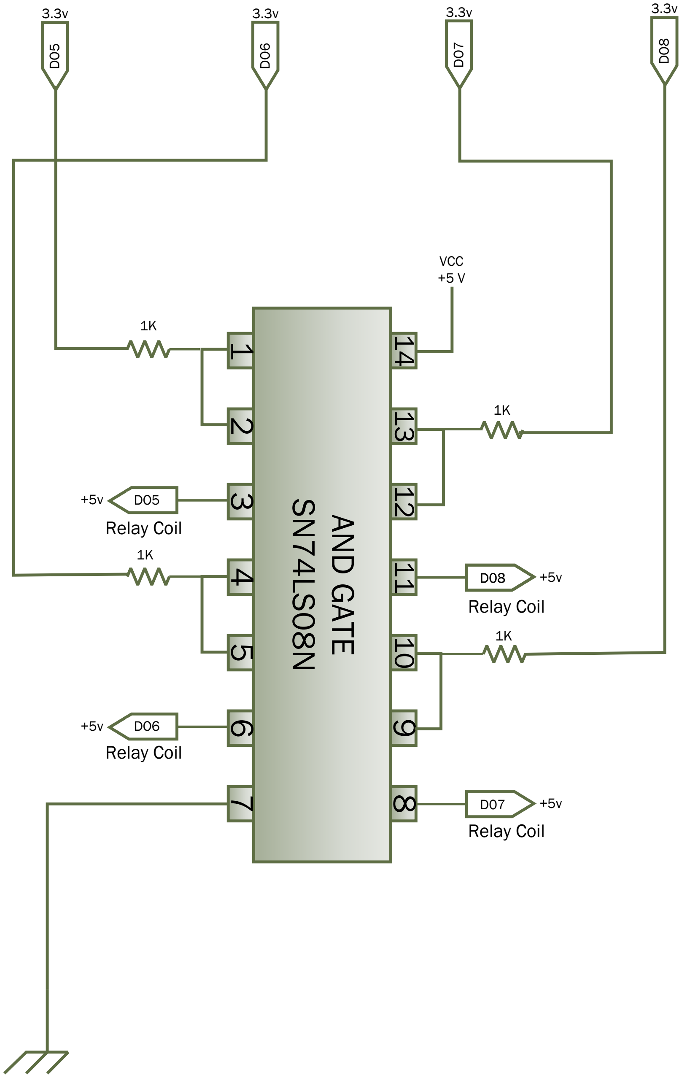
[picture p45: figure]
AND GATE; VCC +5 V; Relay Coil

## Optocoupler Circuit

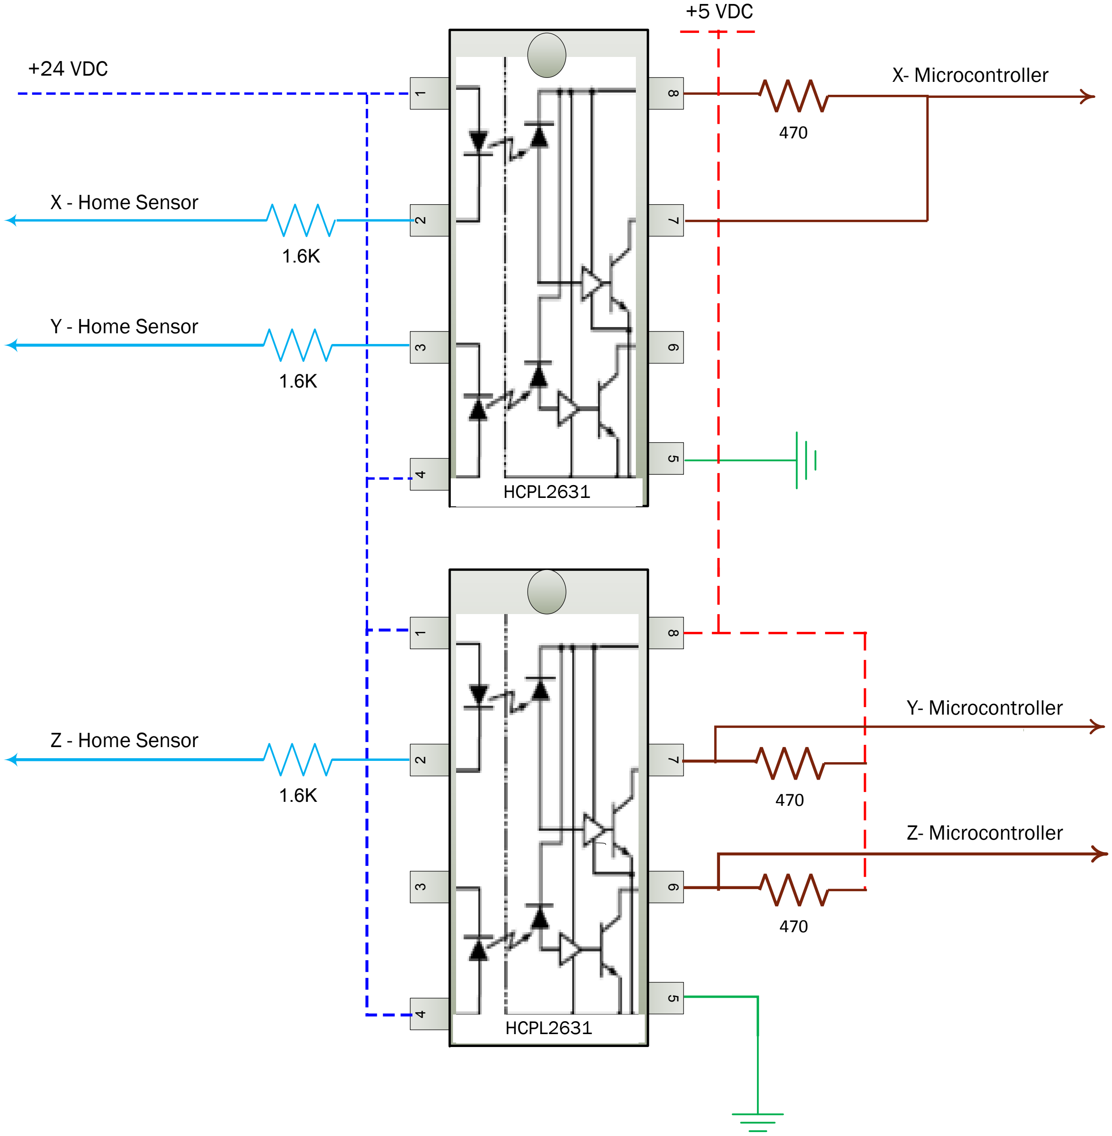
[picture p46: figure]
HCPL2631; +24 VDC; X - Home Sensor; Y - Home Sensor; Z - Home Sensor; +5 VDC; X- Microcontroller; Y- Microcontroller; Z- Microcontroller
