dclarkasm/BartendingRobot/Design/Panel asm1 drawing.pdf

P

R

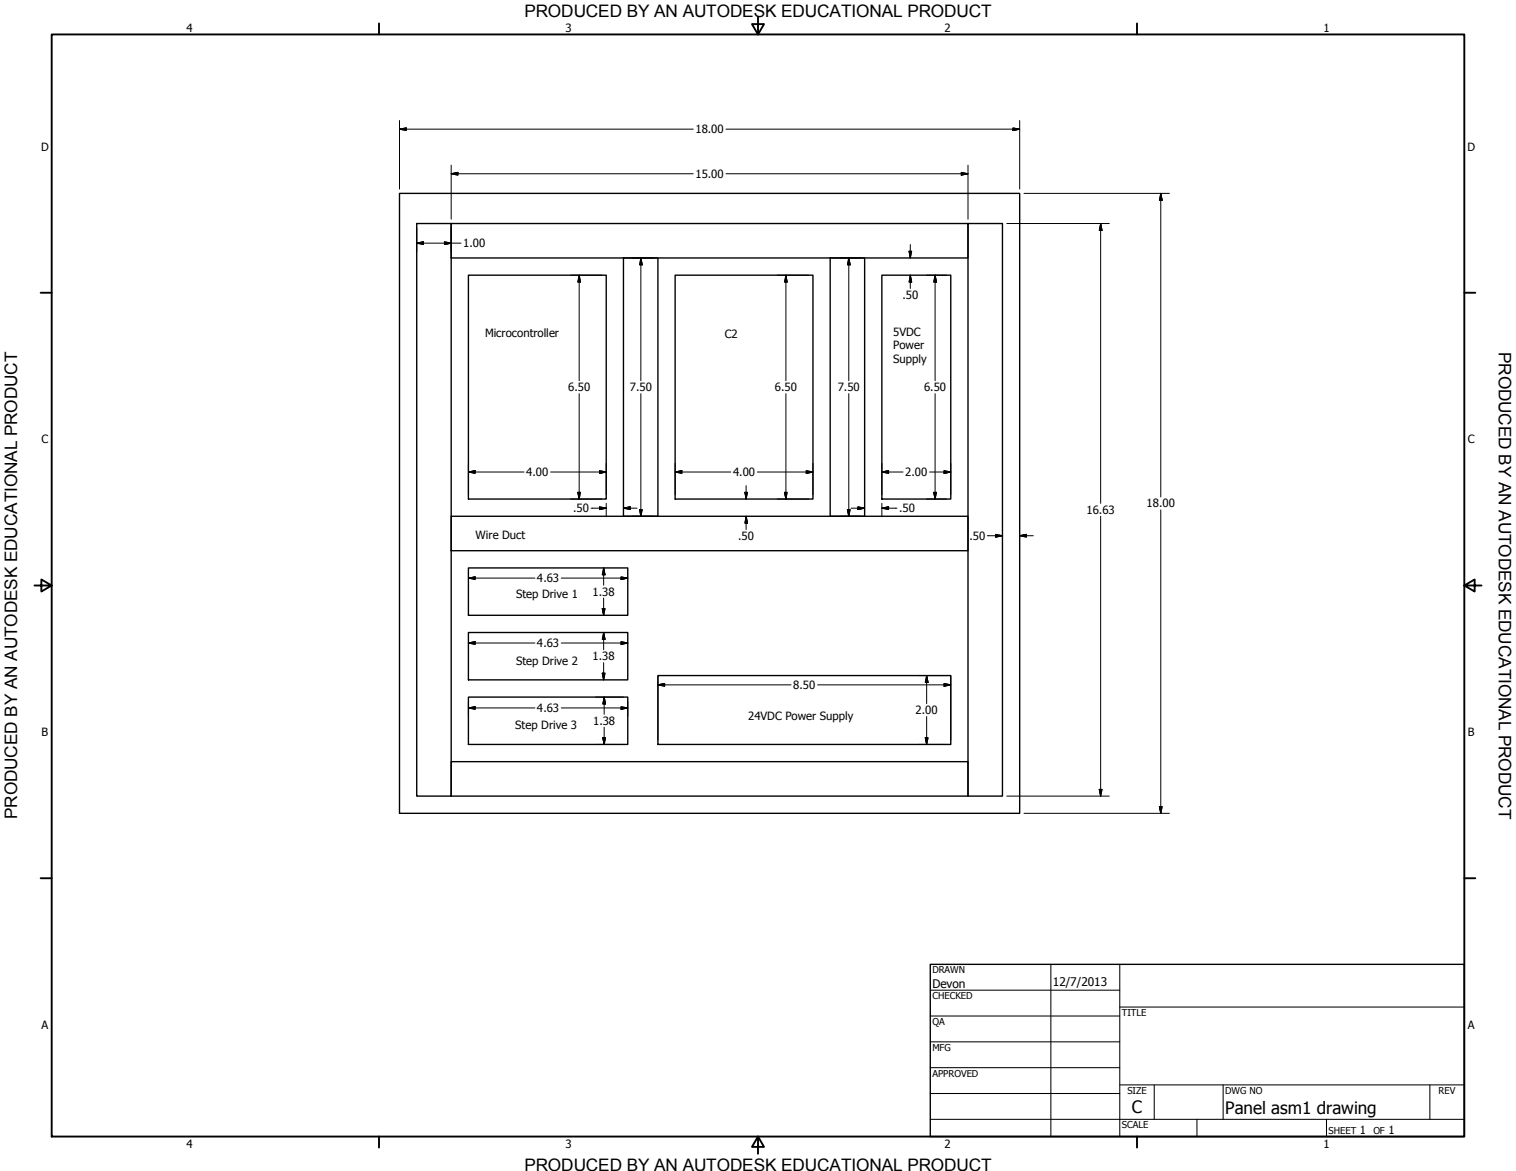
[picture p47: page 1]
TIO N; olle; ply; tSt

PRODUCED BY AN AUTODESK EDUCATIONAL PRODUCT
