dclarkasm/BartendingRobot/Design/machined mounts/motor bracket GL-15N.pdf

P

R

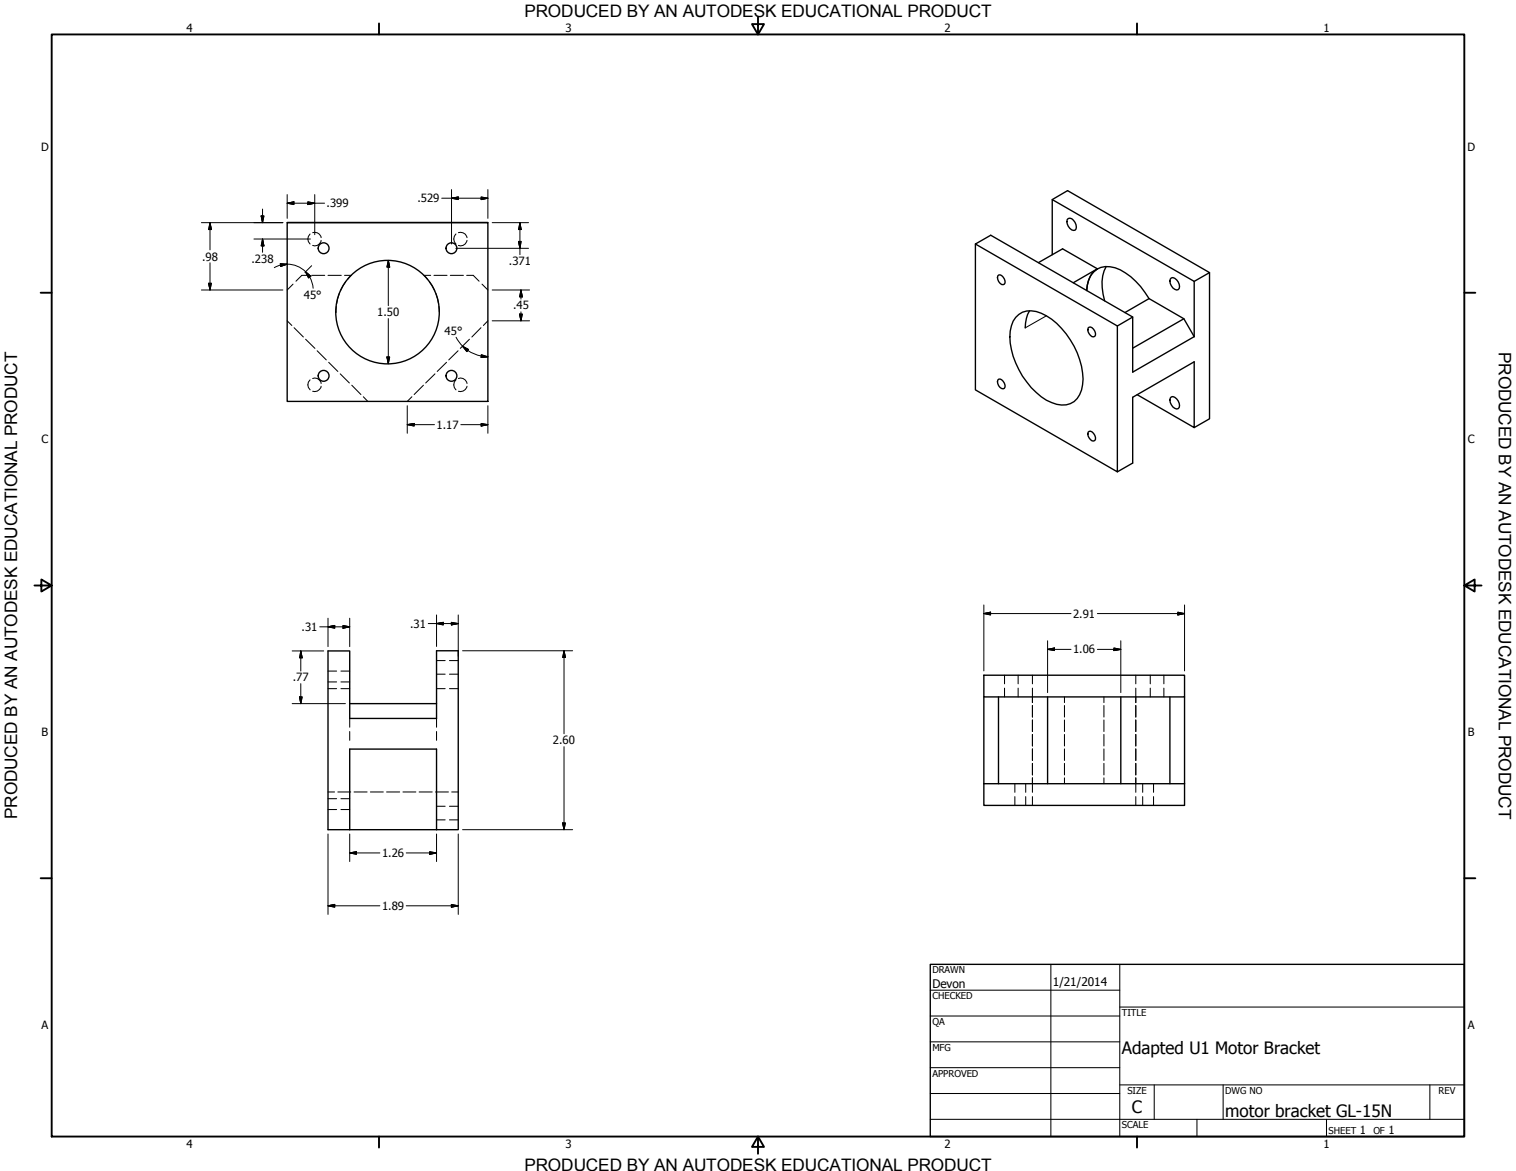
[picture p48: page 1]
TIO N

PRODUCED BY AN AUTODESK EDUCATIONAL PRODUCT
